midnight1337/DigitalGuitarStompbox/Schematic/ArduinoGuitarEffect.sch

## EAGLE design Schematic/ArduinoGuitarEffect.sch (2022-04-16)

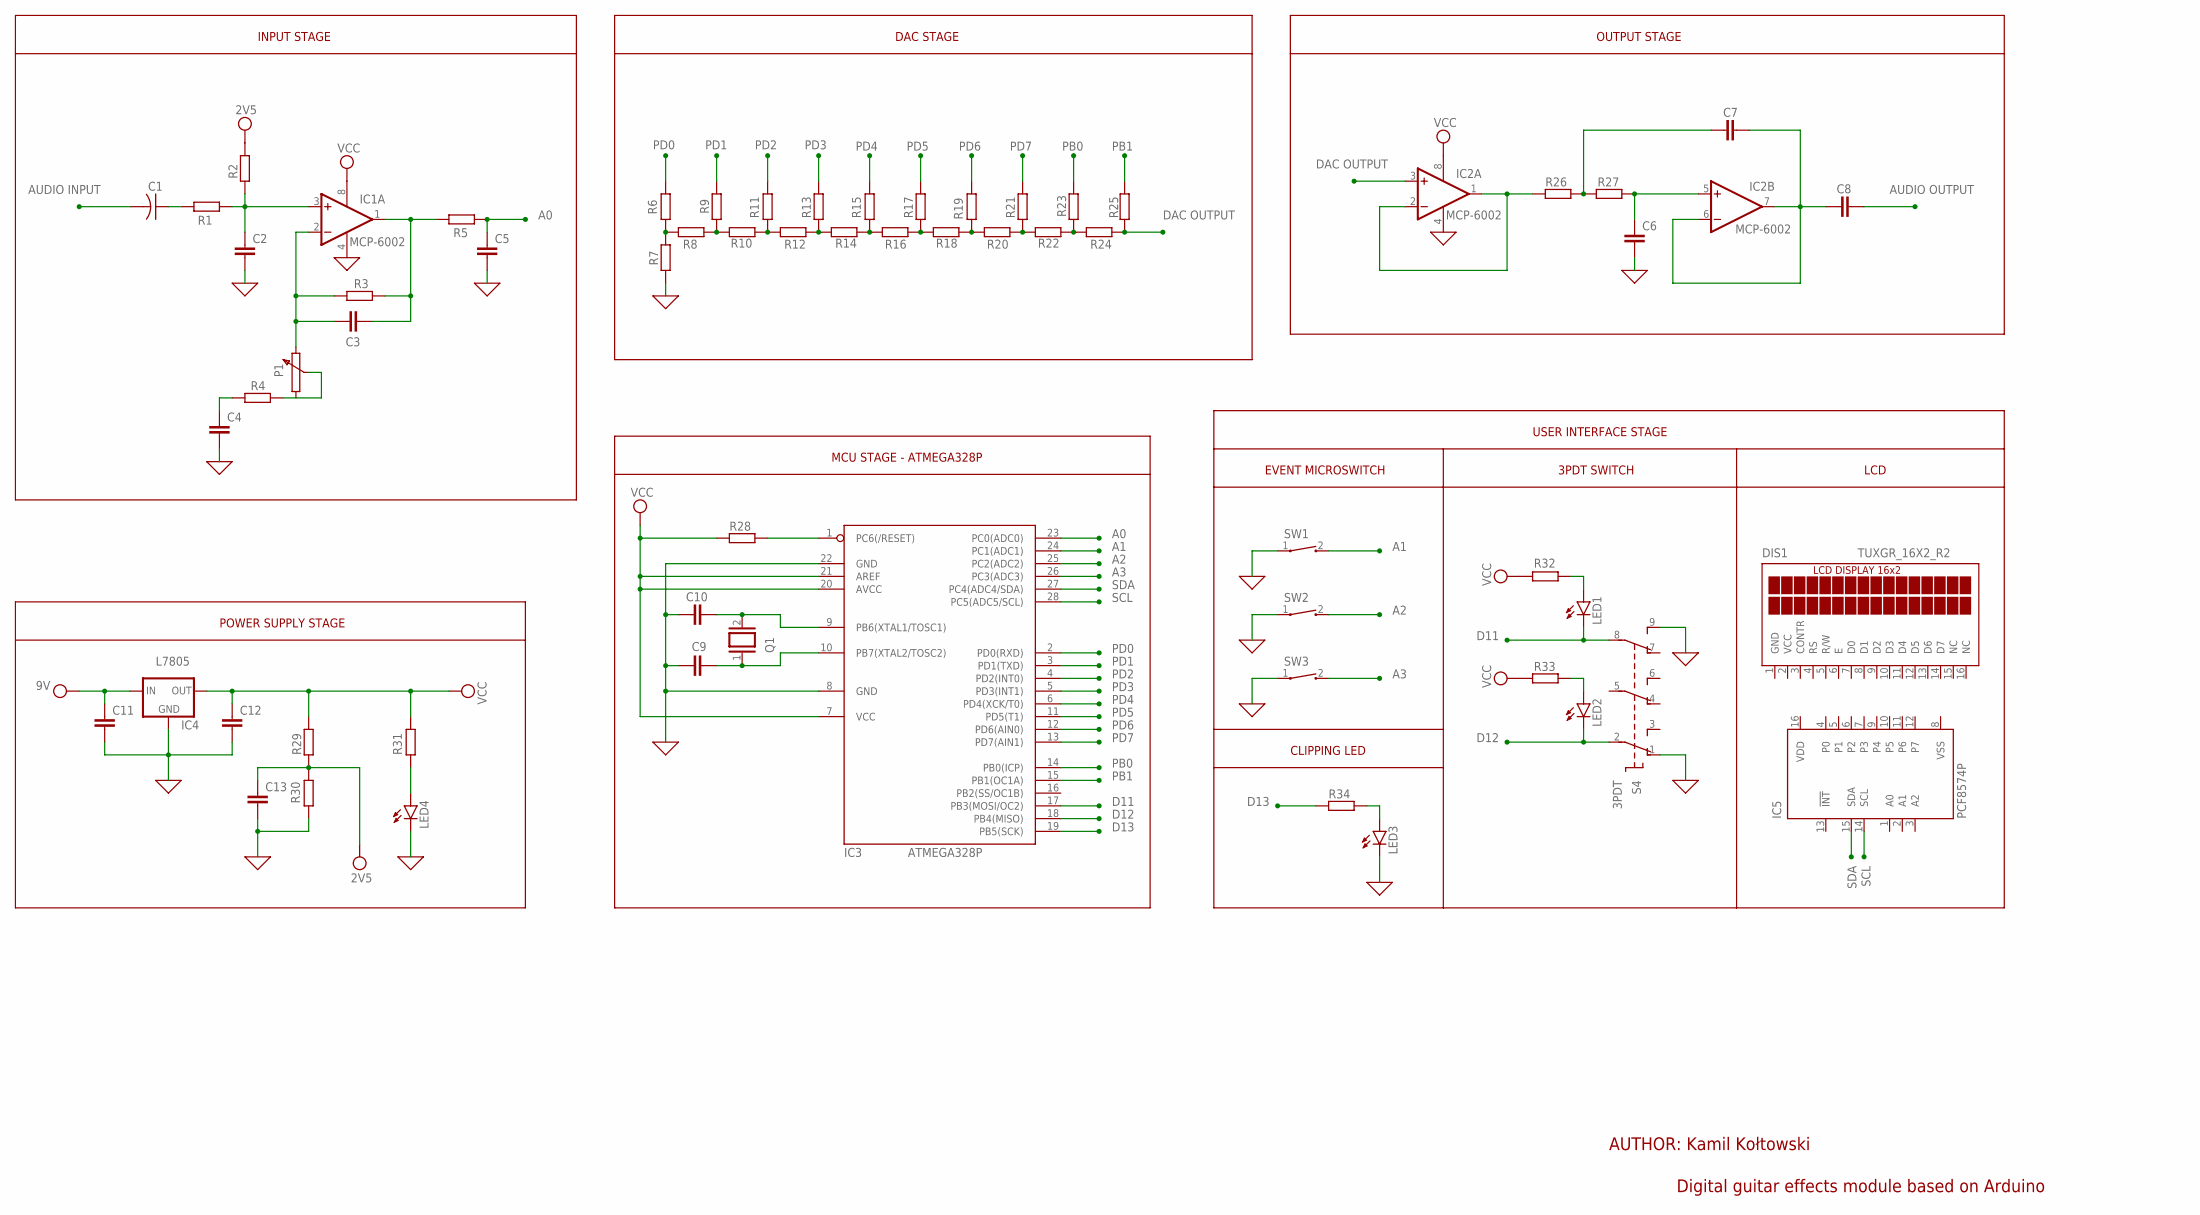
[picture p13: schematic ArduinoGuitarEffect.sch]

Parts:
C1: C-US025-024X044; C025-024X044
C2, C3, C4, C5, C6, C7, C8, C9, C10, C11, C12, C13: C-EU025-024X044; C025-024X044
DIS1: TUXGR_16X2_R2
IC1, IC2: MCP602P; DIL08
IC3: MEGA8-P; DIL28-3
IC4: 78XXS
IC5: PCF8574P; DIL16
LED1, LED2, LED3, LED4: TLLG4400; LED3MM
Q1: XTAL/S; QS
R1, R2, R3, R4, R5, R6, R7, R8, R9, R10, R11, R12, R13, R14, R15, R16, R17, R18, R19, R20, R21, R22, R23, R24, R25, R26, R27, R28, R29, R30, R31, R32, R33, R34: R-EU_0204/7; 0204/7
S4: 3PDT
SW1, SW2, SW3: CT10-XXXX-G4

Connections:
0: C2.2, C4.2, C5.2, C6.2, C9.1, C10.1, C11.2, C12.2, C13.2, IC1.4 (V-), IC2.4 (V-), IC3.8 (GND), IC3.22 (GND), IC4.GND, LED3.K (C), LED4.K (C), R7.1, R30.1, S4.1 (O1), S4.9 (S3), SW1.1, SW2.1, SW3.1
A0: C5.1, IC3.23 (PC0(ADC0)), R5.1
A1: IC3.24 (PC1(ADC1)), SW1.2
A2: IC3.25 (PC2(ADC2)), SW2.2
A3: IC3.26 (PC3(ADC3)), SW3.2
AUDIO_INPUT: C1.2
D11: IC3.17 (PB3(MOSI/OC2)), LED1.K (C), S4.8 (P3)
D12: IC3.18 (PB4(MISO)), LED2.K (C), S4.2 (P1)
D13: IC3.19 (PB5(SCK)), R34.1
unnamed: R6.1, R7.2, R8.2
unnamed: C1.1, R1.1
unnamed: C3.2, IC1.2 (-IN), R3.2
unnamed: C3.1, IC1.1 (OUT), R3.1, R5.2
unnamed: C2.1, IC1.3 (+IN), R1.2, R2.1
unnamed: R8.1, R9.2, R10.1
unnamed: C4.1, R4.2
unnamed: R10.2, R11.1, R12.2
unnamed: R12.1, R13.2, R14.1
unnamed: R14.2, R15.1, R16.2
unnamed: R16.1, R17.2, R18.1
unnamed: R18.2, R19.1, R20.2
unnamed: R20.1, R21.2, R22.1
unnamed: R22.2, R23.1, R24.2
unnamed: R24.1, R25.2
unnamed: C10.2, IC3.9 (PB6(XTAL1/TOSC1)), Q1.2
unnamed: C9.2, IC3.10 (PB7(XTAL2/TOSC2)), Q1.1
unnamed: C13.1, R29.1, R30.2
unnamed: IC2.1 (OUT), IC2.2 (-IN), R26.1
unnamed: C7.1, R26.2, R27.1
unnamed: C6.1, IC2.5 (+IN), R27.2
unnamed: C7.2, C8.1, IC2.6 (-IN), IC2.7 (OUT)
unnamed: LED4.A, R31.1
unnamed: LED1.A, R32.2
unnamed: LED2.A, R33.2
unnamed: IC3.1 (PC6(/RESET)), R28.2
unnamed: LED3.A, R34.2
PB0: IC3.14 (PB0(ICP)), R23.2
PB1: IC3.15 (PB1(OC1A)), R25.1
PD0: IC3.2 (PD0(RXD)), R6.2
PD1: IC3.3 (PD1(TXD)), R9.1
PD2: IC3.4 (PD2(INT0)), R11.2
PD3: IC3.5 (PD3(INT1)), R13.1
PD4: IC3.6 (PD4(XCK/T0)), R15.2
PD5: IC3.11 (PD5(T1)), R17.1
PD6: IC3.12 (PD6(AIN0)), R19.2
PD7: IC3.13 (PD7(AIN1)), R21.1
SCL: IC3.28 (PC5(ADC5/SCL)), IC5.14 (SCL)
SDA: IC3.27 (PC4(ADC4/SDA)), IC5.15 (SDA)
VCC: C11.1, C12.1, IC1.8 (V+), IC2.8 (V+), IC3.7 (VCC), IC3.20 (AVCC), IC3.21 (AREF), IC4.IN, IC4.OUT, R2.2, R28.1, R29.2, R31.2, R32.1, R33.1

Notes on the sheet:
INPUT STAGE
DAC STAGE
AUDIO OUTPUT
AUDIO INPUT
DAC OUTPUT
OUTPUT STAGE
MCU STAGE - ATMEGA328P
ATMEGA328P
L7805
POWER SUPPLY STAGE
USER INTERFACE STAGE
CLIPPING LED
EVENT MICROSWITCH
3PDT SWITCH
LCD
2V5
MCP-6002
Digital guitar effects module based on Arduino
AUTHOR: Kamil Kołtowski
