midnight1337/DigitalGuitarStompbox/Pictures/Distortion.JPG

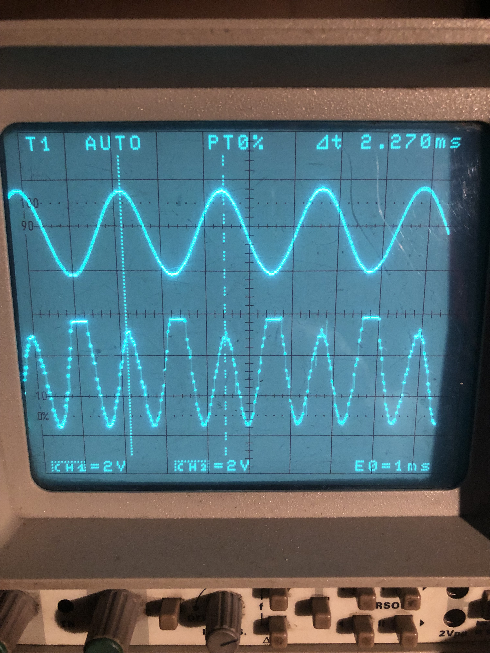
[picture p10: Pictures/Distortion.JPG]
Pictures/Distortion.JPG
